joshuaboud/pixel_eyes/pcb/BOM.ods

Part (Glasses) | Part (Remote) | Value | Footprint | Description | Manufacturer | Part Number | Supplier | Supplier Part Number | Count
R1 |  | 470 | 0603 | LED data in protection | FH(Guangdong Fenghua Advanced Tech) | RS-03K471JT | LCSC | C140089 | 1
R2, R3 |  | 22 | 0603 | USB resistors | FH(Guangdong Fenghua Advanced Tech) | RS-03K220JT | LCSC | C96423 | 2
R4 |  | 1k | 0603 | HWB | Walsin Tech Corp | WR06X102JTL | LCSC | C384295 | 1
 | R1 – R8 | 4.7k | 0603 | Button pull up | YAGEO | RC0603JR-074K7L | LCSC | C105428 | 8
C1 – C12, C17 – C19 | C1 | 100n | 0603 | Supply filtering | CCTC | TCC0603X7R104K500CT | LCSC | C282519 | 16
C13, C14 |  | 1u | 0603 | Supply filtering, UCAP | Samsung Electro-Mechanics | CL10A105KO8NNNC | LCSC | C1592 | 2
C15, C16 |  | 20pf | 0603 | Clock caps | CCTC | TCC0603COG200J500CT | LCSC | C376774 | 2
C20 |  | 10u | 0603 | VBUS Cap | Samsung Electro-Mechanics | CL10A106MP8NNNC | LCSC | C85713 | 1
U1 – U60 |  |  | 2812 | Addressable RGB LEDs | Worldsemi | WS2812S | LCSC | C114584 | 60
J1 | J1 |  |  | Micro USB B | MOLEX | 473460001 | LCSC | C132560 | 2
J2 | J2 |  |  | Interconnect | XKB Connectivity | X1502WRS-05-9TSN | LCSC | C406135 | 2
U61 |  |  | 44-VQFN | MCU | Microchip | ATMega32u4-MUR | LCSC | C45874 | 1
X1 |  | 16MHz | 5x3.2 2 lead | Crystal Osc | TAE(Zhejiang Abel Elec) | SMD-5032_2P 16M 20pf 30ppm | LCSC | C122519 | 1
 | S1 – S8 |  | 6.0x3.5 | Tactile Momentary Switch | USAKRO | UK-B0240-W-250 | LCSC | C780529 | 9
 | U1 |  | TSSOP16 | PISO shift register | Nexperia | 74HC165PW,118 | LCSC | C80696 | 1
 |  |  |  | Wire recptacle | XKB Connectivity | X1502H-05-N0 | LCSC | C697056 | 2
 |  |  |  | Wire terminals | XKB Connectivity | X1502T-PSN | LCSC | C780064 | 10
 |  |  |  | 26 AWG 6 con. Ribbon Cable 1M | Würth Elektronik | 63910615521CAB | Digi-Key | 732-11799-ND | 1
