joshuaboud/pixel_eyes/arms/left_arm.stl

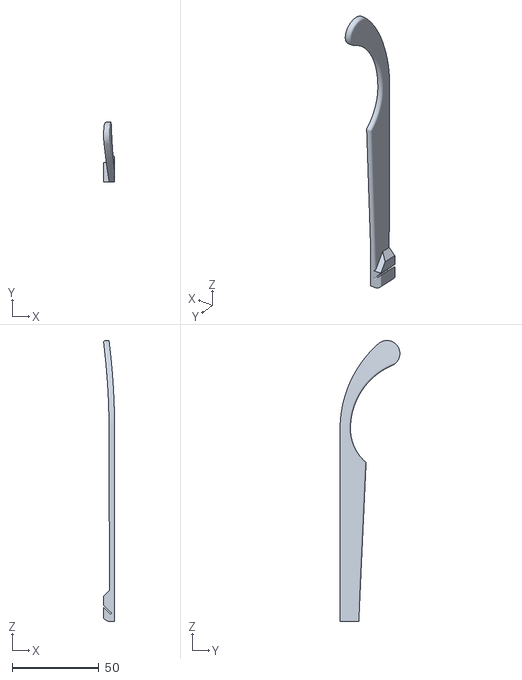
[picture p1: CAD file, 2021-10-08]
arms/left_arm.stl
6.50 x 34.5 x 161.9
