joshuaboud/pixel_eyes/arms/glasses.step

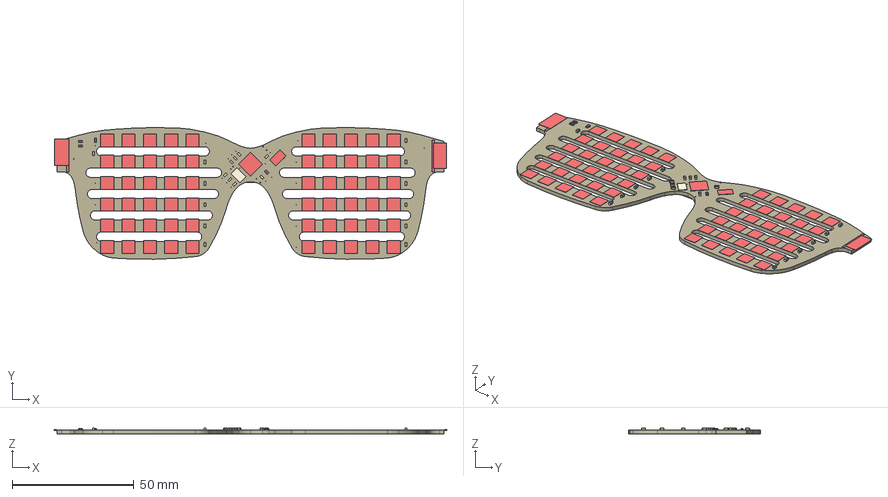
[picture p2: CAD file, 2021-09-07]
arms/glasses.step
160.7 x 53.9 x 2.57 mm
Board
10u x 20
WS2812 x 60
SIGNATURE
LOGO_SILKSCREEN
1k x 4
USB-B-MICRO-SMD
ECS-160-20-3X-TR
32U4
JST-ZH-5SMD-RA
GLASSES_HINGE x 2
MOMENTARY-SWITCH-SPST-SMD-6.0X3.5MM
