joshuaboud/pixel_eyes/(list of files, cad)

Other CAD files:
arms/right_arm.stl
