joshuaboud/pixel_eyes/pcb/controller.brd

## EAGLE design pcb/controller.brd (2021-09-07)

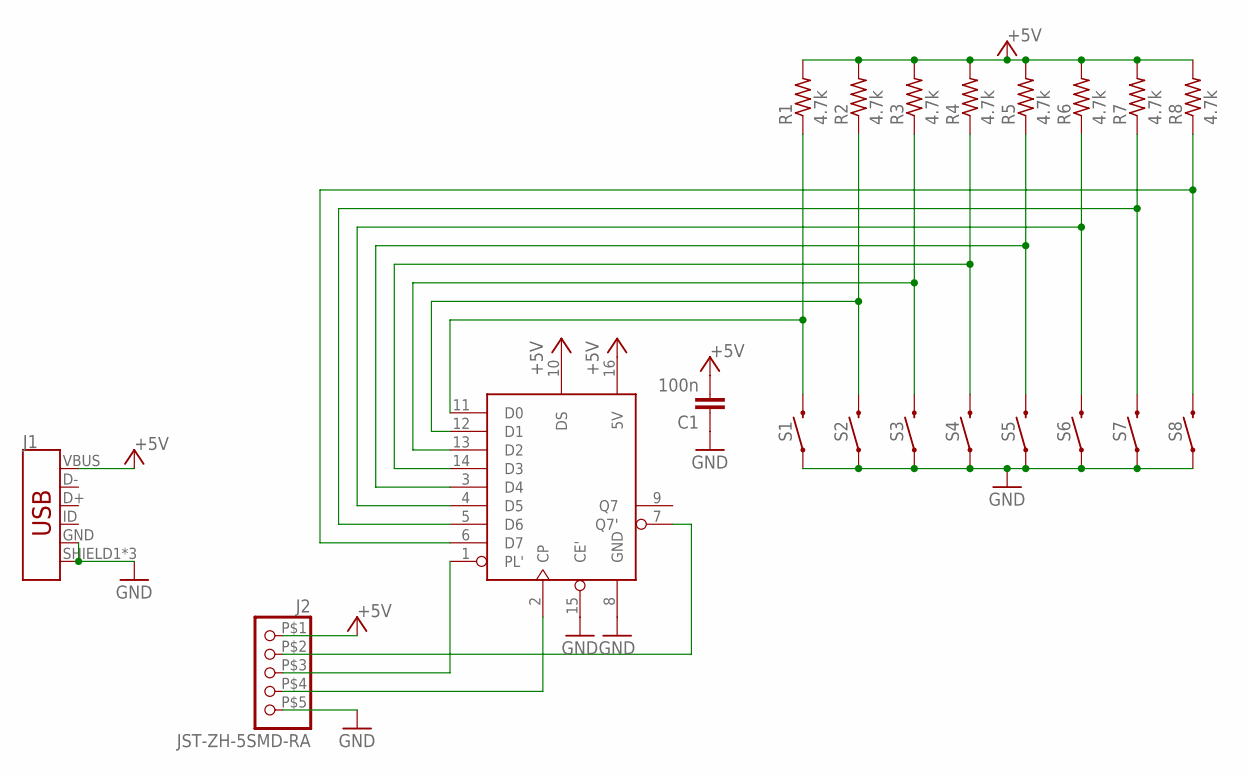
[picture p3: schematic controller.sch]

Parts:
C1: 100n; C0603
J1: USB_MICRO-B_FEMALE-SMT; USB-B-MICRO-SMD
J2: JST-ZH-5SMD-RA; JST-ZH-5-SMD-RA
R1, R2, R3, R4, R5, R6, R7, R8: 4.7k; R0603
S1, S2, S3, S4, S5, S6, S7, S8: MOMENTARY-SWITCH-SPST-SMD-6.0X3.5MM; TACTILE_SWITCH_SMD_6.0X3.5MM
U1: 74HCT165TSSOP16; SOP65P640X110-16N

Connections:
+5V: C1.2, J1.VBUS, J2.P$1 (1), R1.2, R2.2, R3.2, R4.2, R5.2, R6.2, R7.2, R8.2, U1.10 (DS), U1.16 (5V)
GND: C1.1, J1.GND, J1.SHIELD1 (SHIELD), J1.SHIELD2 (SHIELD), J1.SHIELD3 (SHIELD), J2.P$5 (5), S1.1, S2.1, S3.1, S4.1, S5.1, S6.1, S7.1, S8.1, U1.8 (GND), U1.15 (CE')
unnamed: J2.P$4 (4), U1.2 (CP)
unnamed: J2.P$3 (3), U1.1 (PL')
unnamed: J2.P$2 (2), U1.7 (Q7')
unnamed: R1.1, S1.2, U1.11 (D0)
unnamed: R2.1, S2.2, U1.12 (D1)
unnamed: R3.1, S3.2, U1.13 (D2)
unnamed: R4.1, S4.2, U1.14 (D3)
unnamed: R5.1, S5.2, U1.3 (D4)
unnamed: R6.1, S6.2, U1.4 (D5)
unnamed: R7.1, S7.2, U1.5 (D6)
unnamed: R8.1, S8.2, U1.6 (D7)

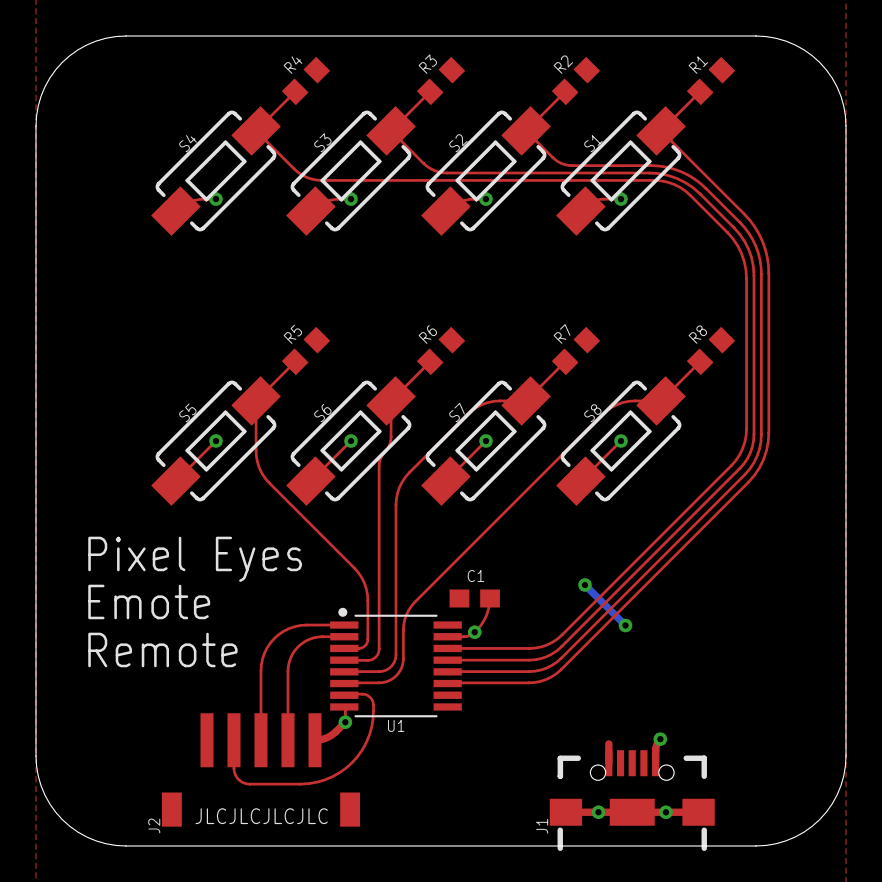
[picture p4: board controller.brd from above]

Board: 2 copper layers, 45.0 x 45.0 mm, 22 parts (2 on the bottom side), 13 nets.

Other parts of the board:
U$1: SIGNATURE
U$3: LOGO_SILKSCREEN
