joshuaboud/pixel_eyes/pcb/glasses.brd

## EAGLE design pcb/glasses.brd (2021-09-07)

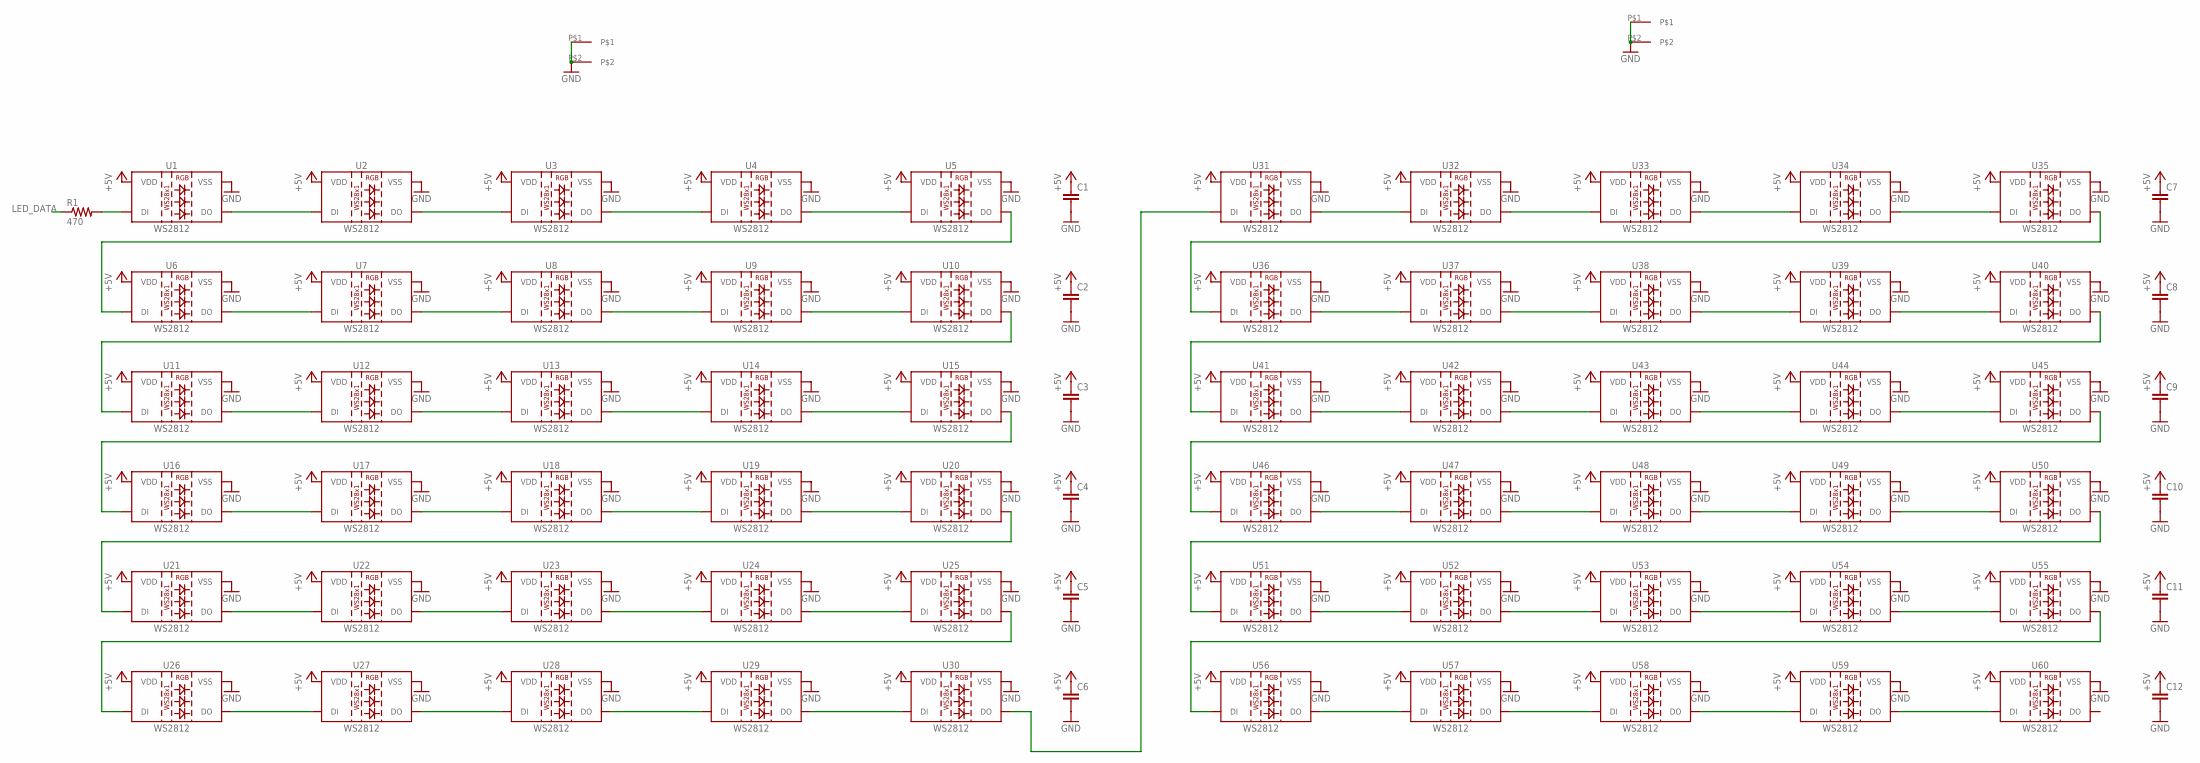
[picture p5: schematic glasses.sch, sheet 1]

Parts:
C1, C2, C3, C4, C5, C6, C7, C8, C9, C10, C11, C12: C-EUC0603; C0603
R1: 470; R0603
U1, U2, U3, U4, U5, U6, U7, U8, U9, U10, U11, U12, U13, U14, U15, U16, U17, U18, U19, U20, U21, U22, U23, U24, U25, U26, U27, U28, U29, U30, U31, U32, U33, U34, U35, U36, U37, U38, U39, U40, U41, U42, U43, U44, U45, U46, U47, U48, U49, U50, U51, U52, U53, U54, U55, U56, U57, U58, U59, U60: WS2812; LED-TRICOLOR-5050-IC
U$4, U$5: GLASSES_HINGE

Connections:
+5V: C1.1, C2.1, C3.1, C4.1, C5.1, C6.1, C7.1, C8.1, C9.1, C10.1, C11.1, C12.1, U1.3 (VDD), U1.5 (VDD), U2.3 (VDD), U2.5 (VDD), U3.3 (VDD), U3.5 (VDD), U4.3 (VDD), U4.5 (VDD), U5.3 (VDD), U5.5 (VDD), U6.3 (VDD), U6.5 (VDD), U7.3 (VDD), U7.5 (VDD), U8.3 (VDD), U8.5 (VDD), U9.3 (VDD), U9.5 (VDD), U10.3 (VDD), U10.5 (VDD), U11.3 (VDD), U11.5 (VDD), U12.3 (VDD), U12.5 (VDD), U13.3 (VDD), U13.5 (VDD), U14.3 (VDD), U14.5 (VDD), U15.3 (VDD), U15.5 (VDD), U16.3 (VDD), U16.5 (VDD), U17.3 (VDD), U17.5 (VDD), U18.3 (VDD), U18.5 (VDD), U19.3 (VDD), U19.5 (VDD), U20.3 (VDD), U20.5 (VDD), U21.3 (VDD), U21.5 (VDD), U22.3 (VDD), U22.5 (VDD), U23.3 (VDD), U23.5 (VDD), U24.3 (VDD), U24.5 (VDD), U25.3 (VDD), U25.5 (VDD), U26.3 (VDD), U26.5 (VDD), U27.3 (VDD), U27.5 (VDD), U28.3 (VDD), U28.5 (VDD), U29.3 (VDD), U29.5 (VDD), U30.3 (VDD), U30.5 (VDD), U31.3 (VDD), U31.5 (VDD), U32.3 (VDD), U32.5 (VDD), U33.3 (VDD), U33.5 (VDD), U34.3 (VDD), U34.5 (VDD), U35.3 (VDD), U35.5 (VDD), U36.3 (VDD), U36.5 (VDD), U37.3 (VDD), U37.5 (VDD), U38.3 (VDD), U38.5 (VDD), U39.3 (VDD), U39.5 (VDD), U40.3 (VDD), U40.5 (VDD), U41.3 (VDD), U41.5 (VDD), U42.3 (VDD), U42.5 (VDD), U43.3 (VDD), U43.5 (VDD), U44.3 (VDD), U44.5 (VDD), U45.3 (VDD), U45.5 (VDD), U46.3 (VDD), U46.5 (VDD), U47.3 (VDD), U47.5 (VDD), U48.3 (VDD), U48.5 (VDD), U49.3 (VDD), U49.5 (VDD), U50.3 (VDD), U50.5 (VDD), U51.3 (VDD), U51.5 (VDD), U52.3 (VDD), U52.5 (VDD), U53.3 (VDD), U53.5 (VDD), U54.3 (VDD), U54.5 (VDD), U55.3 (VDD), U55.5 (VDD), U56.3 (VDD), U56.5 (VDD), U57.3 (VDD), U57.5 (VDD), U58.3 (VDD), U58.5 (VDD), U59.3 (VDD), U59.5 (VDD), U60.3 (VDD), U60.5 (VDD); also elsewhere on the board
GND: C1.2, C2.2, C3.2, C4.2, C5.2, C6.2, C7.2, C8.2, C9.2, C10.2, C11.2, C12.2, U1.6 (VSS), U2.6 (VSS), U3.6 (VSS), U4.6 (VSS), U5.6 (VSS), U6.6 (VSS), U7.6 (VSS), U8.6 (VSS), U9.6 (VSS), U10.6 (VSS), U11.6 (VSS), U12.6 (VSS), U13.6 (VSS), U14.6 (VSS), U15.6 (VSS), U16.6 (VSS), U17.6 (VSS), U18.6 (VSS), U19.6 (VSS), U20.6 (VSS), U21.6 (VSS), U22.6 (VSS), U23.6 (VSS), U24.6 (VSS), U25.6 (VSS), U26.6 (VSS), U27.6 (VSS), U28.6 (VSS), U29.6 (VSS), U30.6 (VSS), U31.6 (VSS), U32.6 (VSS), U33.6 (VSS), U34.6 (VSS), U35.6 (VSS), U36.6 (VSS), U37.6 (VSS), U38.6 (VSS), U39.6 (VSS), U40.6 (VSS), U41.6 (VSS), U42.6 (VSS), U43.6 (VSS), U44.6 (VSS), U45.6 (VSS), U46.6 (VSS), U47.6 (VSS), U48.6 (VSS), U49.6 (VSS), U50.6 (VSS), U51.6 (VSS), U52.6 (VSS), U53.6 (VSS), U54.6 (VSS), U55.6 (VSS), U56.6 (VSS), U57.6 (VSS), U58.6 (VSS), U59.6 (VSS), U60.6 (VSS), U$4.P$1, U$4.P$2, U$5.P$1, U$5.P$2; also elsewhere on the board
LED_DATA: R1.1; also elsewhere on the board
unnamed: U1.1 (DO), U2.2 (DI)
unnamed: U2.1 (DO), U3.2 (DI)
unnamed: U3.1 (DO), U4.2 (DI)
unnamed: U4.1 (DO), U5.2 (DI)
unnamed: U5.1 (DO), U6.2 (DI)
unnamed: U6.1 (DO), U7.2 (DI)
unnamed: U7.1 (DO), U8.2 (DI)
unnamed: U8.1 (DO), U9.2 (DI)
unnamed: U9.1 (DO), U10.2 (DI)
unnamed: U10.1 (DO), U11.2 (DI)
unnamed: U11.1 (DO), U12.2 (DI)
unnamed: U12.1 (DO), U13.2 (DI)
unnamed: U13.1 (DO), U14.2 (DI)
unnamed: U14.1 (DO), U15.2 (DI)
unnamed: U15.1 (DO), U16.2 (DI)
unnamed: U16.1 (DO), U17.2 (DI)
unnamed: U17.1 (DO), U18.2 (DI)
unnamed: U18.1 (DO), U19.2 (DI)
unnamed: U19.1 (DO), U20.2 (DI)
unnamed: U20.1 (DO), U21.2 (DI)
unnamed: U21.1 (DO), U22.2 (DI)
unnamed: U22.1 (DO), U23.2 (DI)
unnamed: U23.1 (DO), U24.2 (DI)
unnamed: U24.1 (DO), U25.2 (DI)
unnamed: U25.1 (DO), U26.2 (DI)
unnamed: U26.1 (DO), U27.2 (DI)
unnamed: U27.1 (DO), U28.2 (DI)
unnamed: U28.1 (DO), U29.2 (DI)
unnamed: U29.1 (DO), U30.2 (DI)
unnamed: U31.1 (DO), U32.2 (DI)
unnamed: U32.1 (DO), U33.2 (DI)
unnamed: U33.1 (DO), U34.2 (DI)
unnamed: U34.1 (DO), U35.2 (DI)
unnamed: U35.1 (DO), U36.2 (DI)
unnamed: U36.1 (DO), U37.2 (DI)
unnamed: U37.1 (DO), U38.2 (DI)
unnamed: U38.1 (DO), U39.2 (DI)
unnamed: U39.1 (DO), U40.2 (DI)
unnamed: U40.1 (DO), U41.2 (DI)
unnamed: U41.1 (DO), U42.2 (DI)
unnamed: U42.1 (DO), U43.2 (DI)
unnamed: U43.1 (DO), U44.2 (DI)
unnamed: U44.1 (DO), U45.2 (DI)
unnamed: U45.1 (DO), U46.2 (DI)
unnamed: U46.1 (DO), U47.2 (DI)
unnamed: U47.1 (DO), U48.2 (DI)
unnamed: U48.1 (DO), U49.2 (DI)
unnamed: U49.1 (DO), U50.2 (DI)
unnamed: U50.1 (DO), U51.2 (DI)
unnamed: U51.1 (DO), U52.2 (DI)
unnamed: U52.1 (DO), U53.2 (DI)
unnamed: U53.1 (DO), U54.2 (DI)
unnamed: U54.1 (DO), U55.2 (DI)
unnamed: U55.1 (DO), U56.2 (DI)
unnamed: U56.1 (DO), U57.2 (DI)
unnamed: U57.1 (DO), U58.2 (DI)
unnamed: U58.1 (DO), U59.2 (DI)
unnamed: U59.1 (DO), U60.2 (DI)
unnamed: U30.1 (DO), U31.2 (DI)
unnamed: R1.2, U1.2 (DI)

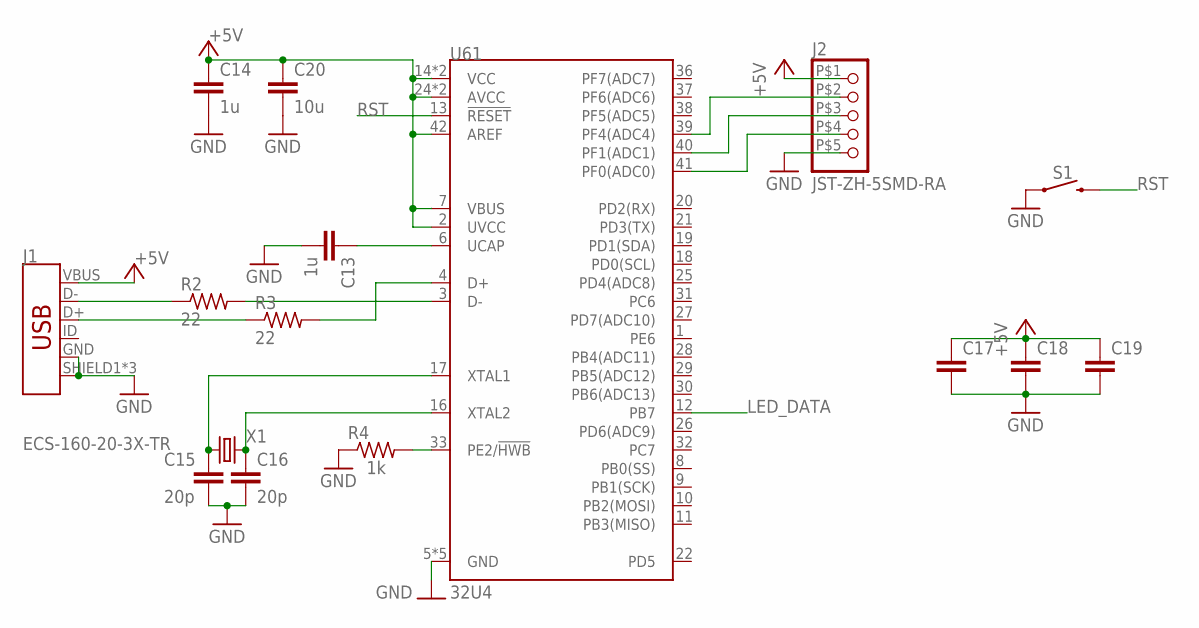
[picture p6: schematic glasses.sch, sheet 2]

Parts:
C13, C14: 1u; C0603
C15, C16: 20p; C0603
C17, C18, C19: C-EUC0603; C0603
C20: 10u; C0603
J1: USB_MICRO-B_FEMALE-SMT; USB-B-MICRO-SMD
J2: JST-ZH-5SMD-RA; JST-ZH-5-SMD-RA
R2, R3: 22; R0603
R4: 1k; R0603
S1: MOMENTARY-SWITCH-SPST-SMD-6.0X3.5MM; TACTILE_SWITCH_SMD_6.0X3.5MM
U61: 32U4; QFN-44
X1: ECS-160-20-3X-TR; CRYSTAL-SMD-5X3.2-2PAD

Connections:
+5V: C14.1, C17.1, C18.1, C19.1, C20.1, J1.VBUS, J2.P$1 (1), U61.2 (UVCC), U61.7 (VBUS), U61.14 (VCC), U61.24 (AVCC), U61.34 (VCC), U61.42 (AREF), U61.44 (AVCC); also elsewhere on the board
GND: C13.2, C14.2, C15.2, C16.2, C17.2, C18.2, C19.2, C20.2, J1.GND, J1.SHIELD1 (SHIELD), J1.SHIELD2 (SHIELD), J1.SHIELD3 (SHIELD), J2.P$5 (5), R4.1, S1.1, U61.5 (GND), U61.15 (GND), U61.23 (GND), U61.35 (GND), U61.43 (GND); also elsewhere on the board
LED_DATA: U61.12 (PB7); also elsewhere on the board
unnamed: J2.P$4 (4), U61.41 (PF0(ADC0))
unnamed: C13.1, U61.6 (UCAP)
unnamed: J2.P$3 (3), U61.40 (PF1(ADC1))
unnamed: J2.P$2 (2), U61.39 (PF4(ADC4))
unnamed: C16.1, U61.16 (XTAL2), X1.P$2 (2)
unnamed: C15.1, U61.17 (XTAL1), X1.P$1 (1)
unnamed: R4.2, U61.33 (PE2/!HWB)
RST: S1.2, U61.13 (!RESET)
USB1_N: J1.D-, R2.1
USB1_P: J1.D+, R3.1
USB_N: R2.2, U61.3 (D-)
USB_P: R3.2, U61.4 (D+)

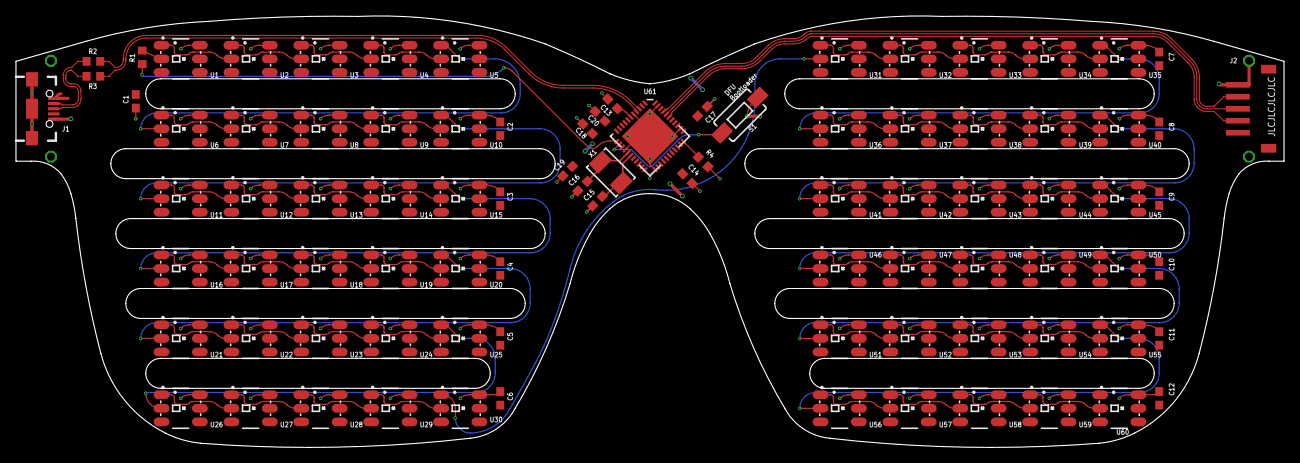
[picture p7: board glasses.brd from above]

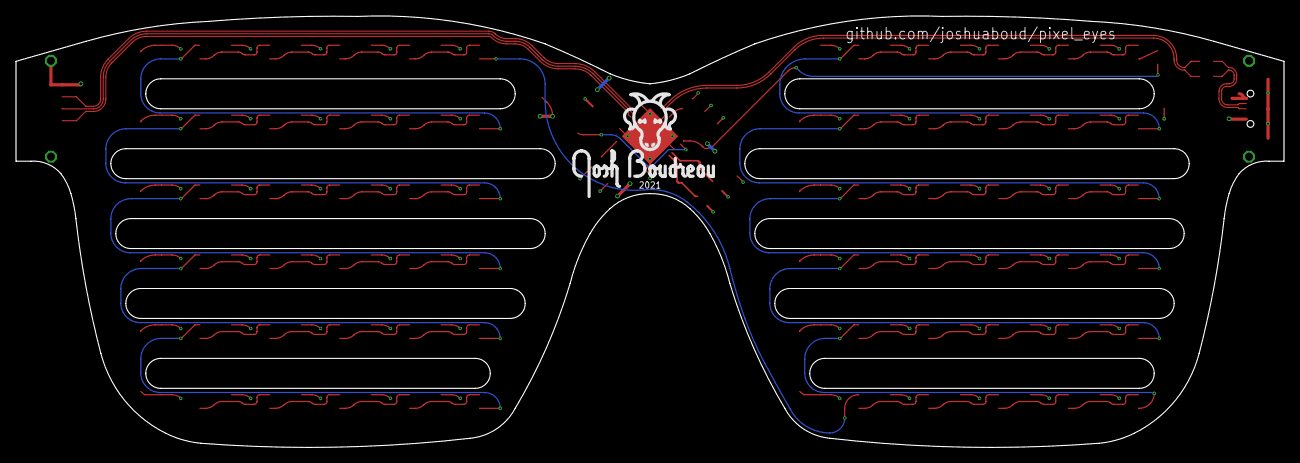
[picture p8: board glasses.brd from below]

Board: 2 copper layers, 158.8 x 54.0 mm, 93 parts (2 on the bottom side), 75 nets.

Other parts of the board:
U$1: SIGNATURE
U$2: LOGO_SILKSCREEN
