joshuaboud/pixel_eyes/(commit log)

2021-08-13 start route data lines
    [eye.brd, eye.sch]
2021-08-13 finish wiring
    [eye.brd]
2021-08-13 change connector to TE AMP 171826-3
    [eye.brd, eye.sch]
2021-08-16 start controller design
    [controller.sch]
2021-08-16 change to non-arduino atmega32u4
    [controller.sch]
2021-08-18 create Frame struct
2021-08-19 remove LED number output
2021-08-20 implement saving frames to .c file
2021-08-24 implement saving, loading, frame insert/delete
2021-08-24 append frame to end
2021-08-24 add edit frames target
2021-08-30 add previewing frames
2021-08-30 save frames
2021-09-05 make full glasses and add mcu to them
    [eye.brd, eye.sch]
2021-09-06 finish up glasses
    [eye.brd, eye.sch]
2021-09-06 finish controller
    [controller.brd, controller.sch]
2021-09-06 update resistor values
    [controller.brd, controller.sch]
2021-09-06 update values and name placement
    [controller.brd, controller.sch, eye.brd, eye.sch]
2021-09-06 start bill of materials
    [BOM.ods]
2021-09-06 add connector devices
2021-09-06 touch up silkscreen and traces
    [controller.brd, eye.brd, eye.sch]
2021-09-06 add more parts
    [BOM.ods]
2021-09-06 finish BOM, TODO: digi-key pn's
    [BOM.ods]
2021-09-06 not sure what changed
    [BOM.ods]
2021-09-06 order from LCSC instead
    [BOM.ods]
2021-09-06 optimize some routing
    [eye.brd, eye.sch]
2021-09-06 add restrict under MCU
    [eye.brd]
2021-09-06 connect MCU grounds under EP
    [eye.brd]
2021-09-06 fix X1 silkscreen and caps
    [eye.brd]
2021-09-06 add reset switch to count
    [BOM.ods]
2021-09-06 fix font
    [eye.brd]
2021-09-07 add 10uF VBUS cap
    [BOM.ods, eye.brd, eye.sch]
2021-09-07 fix paste on mcu
    [eye.brd, eye.sch]
2021-09-07 add gerber files
2021-09-07 place JLC number under connector and add year
    [controller.brd, glasses.brd]
2021-09-07 update silkscreen
2021-09-07 ran DRC and moved vias
    [glasses.brd]
2021-09-07 update BOM
    [BOM.ods]
2021-09-07 ran DRC
    [controller.brd]
2021-09-07 add step file for glasses PCB to model arms
    [glasses.step]
2021-09-07 make all eye frames copy
2021-09-30 update output pin
2021-10-07 remove ninth frame
2021-10-07 reset duration counter when changing emote
    [main.c]
2021-10-08 add glasses arms STLs
    [left_arm.stl, right_arm.stl]
2021-10-08 finalise arms
    [left_arm.stl, right_arm.stl]
